Kybernetika-SPSE/DMP_Hep/PROJEKTOVA_DATA/Dilci_vypracovani/unor.docx

Dílčí vypracování únor:

Vyleptal jsem, osadil a zprovoznil plošný spoj pro vyhodnocování příchozích impulzů. Vše jsem zkompletoval a zprovoznil.

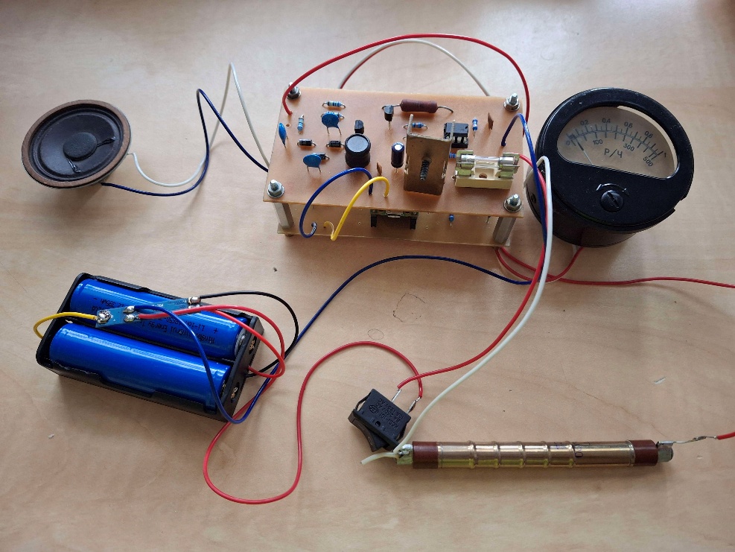
[picture p11: figure]
Obsah obrázku elektronika, Elektrické vedení, kabel, Elektronické inženýrství Obsah vygenerovaný umělou inteligencí může být nesprávný.

Dále jsem navrhl krabici, ke které bude celý produkt uložen.

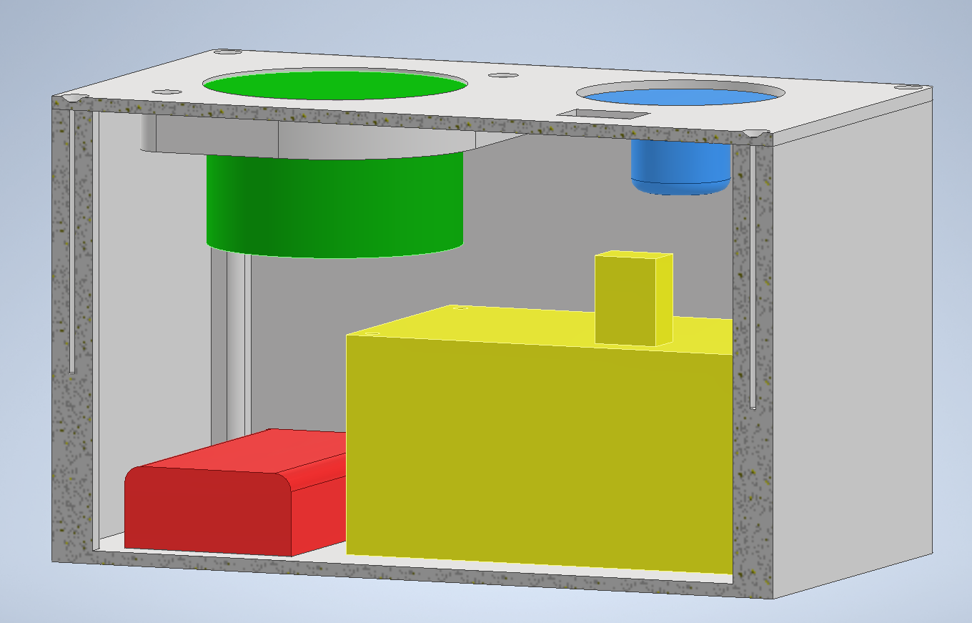
[picture p12: figure]
Obsah obrázku design Obsah vygenerovaný umělou inteligencí může být nesprávný.

Dále jsem se předběžně domluvil se známým, co je radiolog na kalibraci (zapůjčení zářiče se známou aktivitou).
