Kybernetika-SPSE/DMP_Hep/PROJEKTOVA_DATA/GeigerCounter/probe_2.stl

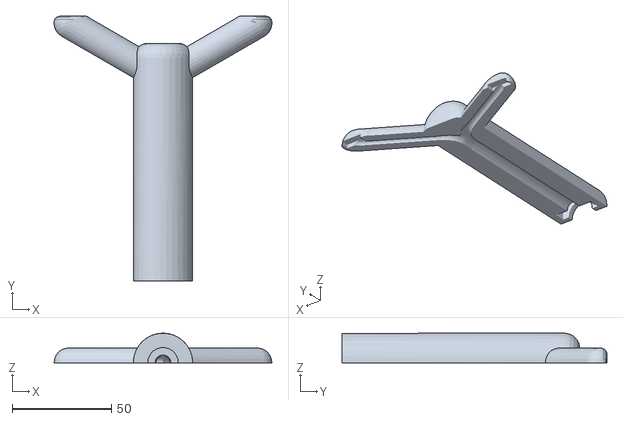
[picture p13: CAD file, 2025-04-10]
PROJEKTOVA_DATA/GeigerCounter/probe_2.stl
110.0 x 133.8 x 15.0
