Kybernetika-SPSE/DMP_Hep/PROJEKTOVA_DATA/GeigerCounter/cover.stl

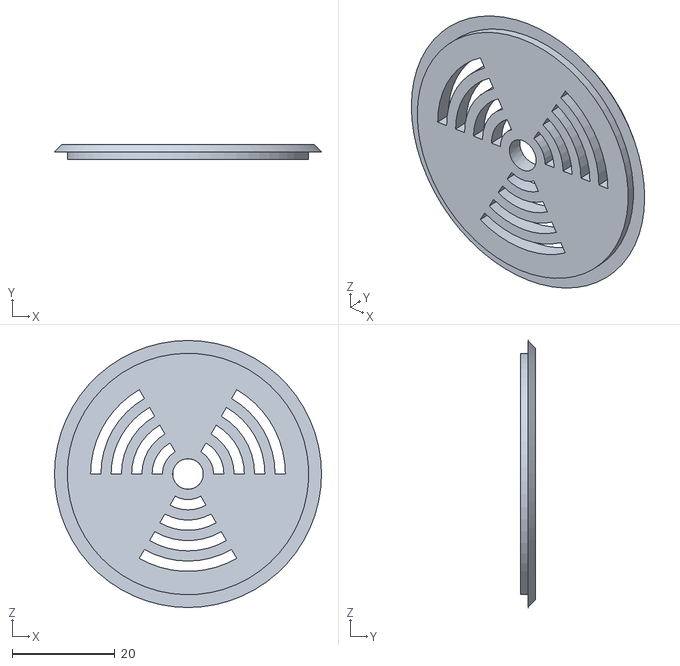
[picture p14: CAD file, 2025-04-10]
PROJEKTOVA_DATA/GeigerCounter/cover.stl
52.1 x 3.00 x 52.1
