Kybernetika-SPSE/DMP_Hep/PROJEKTOVA_DATA/GeigerCounter/probe_1.stl

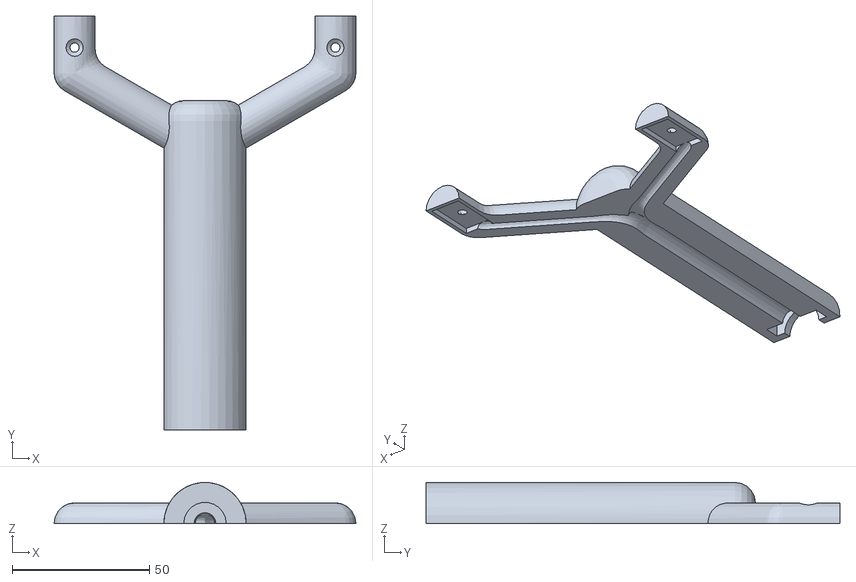
[picture p15: CAD file, 2025-04-10]
PROJEKTOVA_DATA/GeigerCounter/probe_1.stl
110.0 x 150.8 x 15.0
