Kybernetika-SPSE/DMP_Hep/PROJEKTOVA_DATA/GeigerCounter/box_bottom.stl

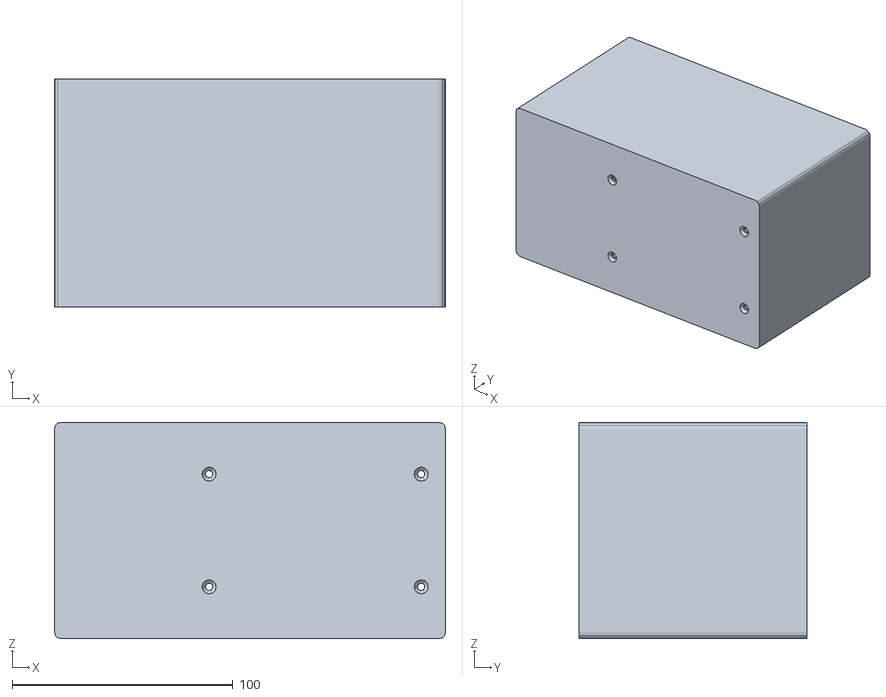
[picture p16: CAD file, 2025-03-24]
PROJEKTOVA_DATA/GeigerCounter/box_bottom.stl
177.0 x 103.0 x 98.0
