Kybernetika-SPSE/DMP_Hep/PROJEKTOVA_DATA/GeigerCounter/holder.stl

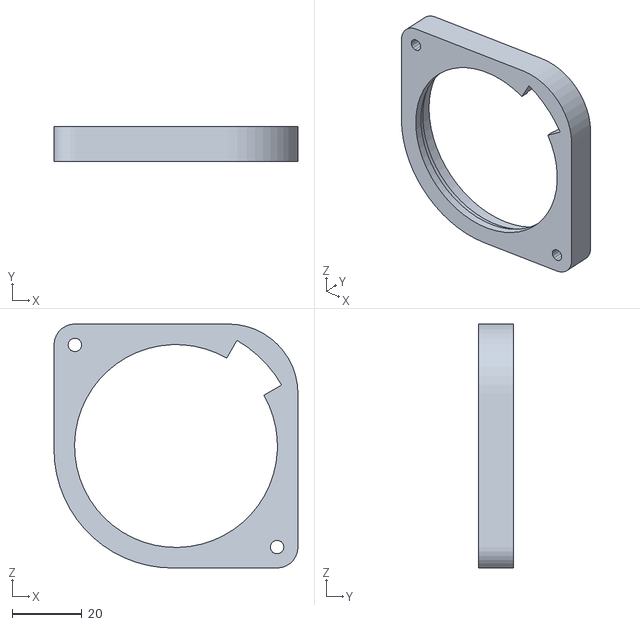
[picture p17: CAD file, 2025-03-24]
PROJEKTOVA_DATA/GeigerCounter/holder.stl
70.0 x 10.0 x 70.0
