Kybernetika-SPSE/DMP_Hep/PROJEKTOVA_DATA/GeigerCounter/box_top.stl

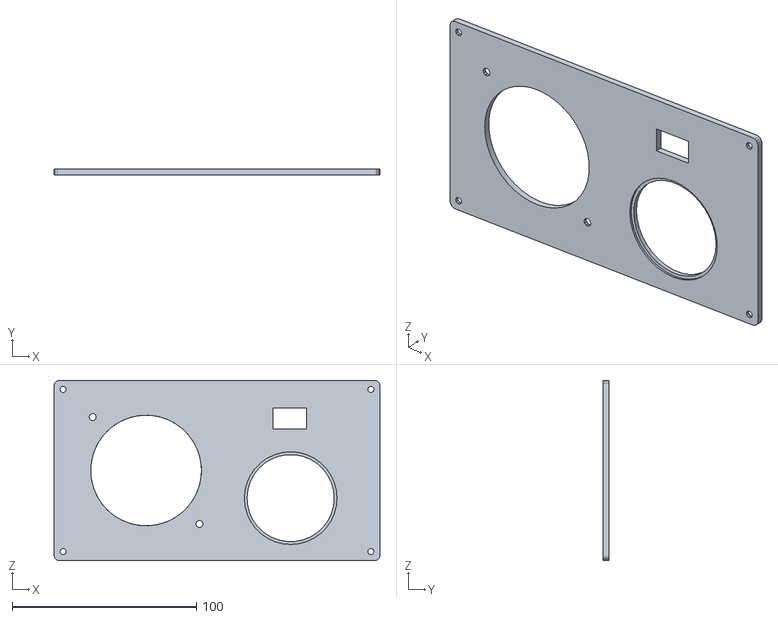
[picture p18: CAD file, 2025-03-24]
PROJEKTOVA_DATA/GeigerCounter/box_top.stl
177.0 x 3.00 x 98.0
