Kybernetika-SPSE/DMP_Hep/(list of files, cad)

Other CAD files:
PROJEKTOVA_DATA/GeigerCounter/MECHANISMUS TÁHLOVÝ.idw
PROJEKTOVA_DATA/GeigerCounter/OldVersions/Sestava1.0015.iam
PROJEKTOVA_DATA/GeigerCounter/OldVersions/Sestava2.0001.iam
PROJEKTOVA_DATA/GeigerCounter/OldVersions/box.0002.iam
PROJEKTOVA_DATA/GeigerCounter/OldVersions/box.0005.idw
PROJEKTOVA_DATA/GeigerCounter/OldVersions/box_bottom.0008.idw
PROJEKTOVA_DATA/GeigerCounter/OldVersions/box_bottom.0011.ipt
PROJEKTOVA_DATA/GeigerCounter/OldVersions/box_top.0007.idw
PROJEKTOVA_DATA/GeigerCounter/OldVersions/box_top.0011.ipt
PROJEKTOVA_DATA/GeigerCounter/OldVersions/cover.0005.idw
PROJEKTOVA_DATA/GeigerCounter/OldVersions/cover.0005.ipt
PROJEKTOVA_DATA/GeigerCounter/OldVersions/holder.0008.idw
PROJEKTOVA_DATA/GeigerCounter/OldVersions/holder.0012.ipt
PROJEKTOVA_DATA/GeigerCounter/OldVersions/probe.0002.iam
PROJEKTOVA_DATA/GeigerCounter/OldVersions/probe.0004.idw
PROJEKTOVA_DATA/GeigerCounter/OldVersions/probe_1.0004.idw
PROJEKTOVA_DATA/GeigerCounter/OldVersions/probe_1.0014.ipt
PROJEKTOVA_DATA/GeigerCounter/OldVersions/probe_2.0003.idw
PROJEKTOVA_DATA/GeigerCounter/OldVersions/probe_2.0004.ipt
PROJEKTOVA_DATA/GeigerCounter/OldVersions/prop.0001.ipt
PROJEKTOVA_DATA/GeigerCounter/OldVersions/prop_PCB.0002.ipt
PROJEKTOVA_DATA/GeigerCounter/OldVersions/prop_battery.0001.ipt
PROJEKTOVA_DATA/GeigerCounter/OldVersions/prop_meter.0001.ipt
PROJEKTOVA_DATA/GeigerCounter/OldVersions/prop_speaker.0001.ipt
PROJEKTOVA_DATA/GeigerCounter/OldVersions/stupnice.0010.idw
PROJEKTOVA_DATA/GeigerCounter/Sestava1.iam
PROJEKTOVA_DATA/GeigerCounter/Sestava2.iam
PROJEKTOVA_DATA/GeigerCounter/box.iam
PROJEKTOVA_DATA/GeigerCounter/box.idw
PROJEKTOVA_DATA/GeigerCounter/box_bottom.idw
PROJEKTOVA_DATA/GeigerCounter/box_bottom.ipt
PROJEKTOVA_DATA/GeigerCounter/box_top.idw
PROJEKTOVA_DATA/GeigerCounter/box_top.ipt
PROJEKTOVA_DATA/GeigerCounter/cover.idw
PROJEKTOVA_DATA/GeigerCounter/cover.ipt
PROJEKTOVA_DATA/GeigerCounter/holder.idw
PROJEKTOVA_DATA/GeigerCounter/holder.ipt
PROJEKTOVA_DATA/GeigerCounter/probe.iam
PROJEKTOVA_DATA/GeigerCounter/probe.idw
PROJEKTOVA_DATA/GeigerCounter/probe_1.idw
PROJEKTOVA_DATA/GeigerCounter/probe_1.ipt
PROJEKTOVA_DATA/GeigerCounter/probe_2.idw
PROJEKTOVA_DATA/GeigerCounter/probe_2.ipt
PROJEKTOVA_DATA/GeigerCounter/prop.ipt
PROJEKTOVA_DATA/GeigerCounter/prop_PCB.ipt
PROJEKTOVA_DATA/GeigerCounter/prop_battery.ipt
PROJEKTOVA_DATA/GeigerCounter/prop_meter.ipt
PROJEKTOVA_DATA/GeigerCounter/prop_speaker.ipt
PROJEKTOVA_DATA/GeigerCounter/stupnice.idw
