Kybernetika-SPSE/DMP_Hep/PRILOHY/PŘÍLOHA I - BOX_S_VÍKEM/box.pdf

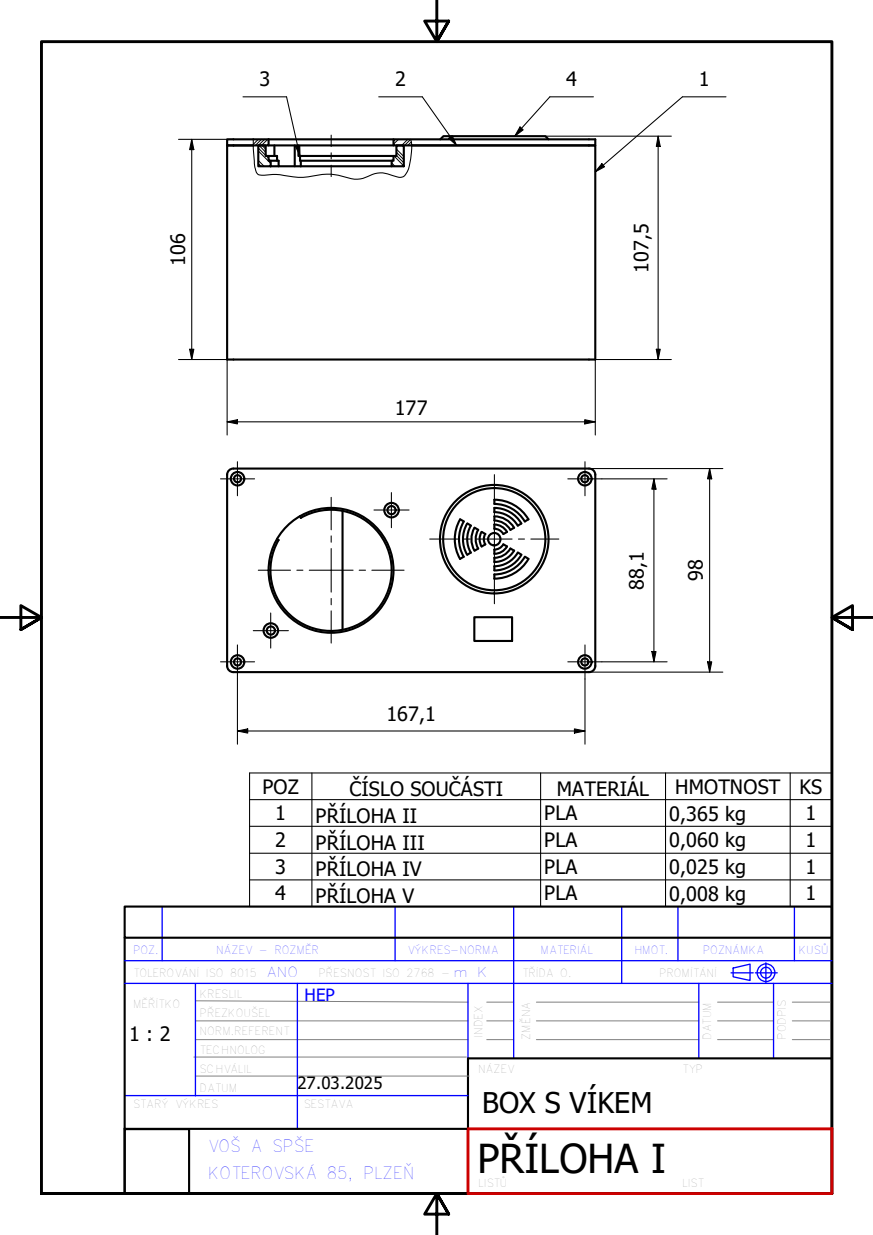
[picture p19: page 1]

POZ | ČÍSLO SOUČÁSTI | MATERIÁL | HMOTNOST | KS
1 | PŘÍLOHA II | PLA | 0,365 kg | 1
2 | PŘÍLOHA III | PLA | 0,060 kg | 1
3 | PŘÍLOHA IV | PLA | 0,025 kg | 1
4 | PŘÍLOHA V | PLA | 0,008 kg | 1

POZ. | NÁZEV - ROZMĚR | VÝKRES-NORMA | MATERIÁL | HMOT. | POZNÁMKA | KUSŮ

TOLEROVÁNÍ ISO 8015 ANO PŘESNOST ISO 2768 -m K | TŘÍDA O. | PROMÍTÁNÍ

MĚŘÍTKO 1 : 2 | KRESLIL | HEP

PŘEZKOUŠEL

NORM.REFERENT
TECHNOLOG
SCHVÁLIL | | NÁZEV TYP BOX S VÍKEM
DATUM | 27.03.2025

STARÝ VÝKRES | | SESTAVA

VOŠ A SPŠE KOTEROVSKÁ 85, PLZEŇ | PŘÍLOHA I LISTŮ LIST
