Kybernetika-SPSE/DMP_Hep/PRILOHY/PŘÍLOHA II - BOX/box_bottom.pdf

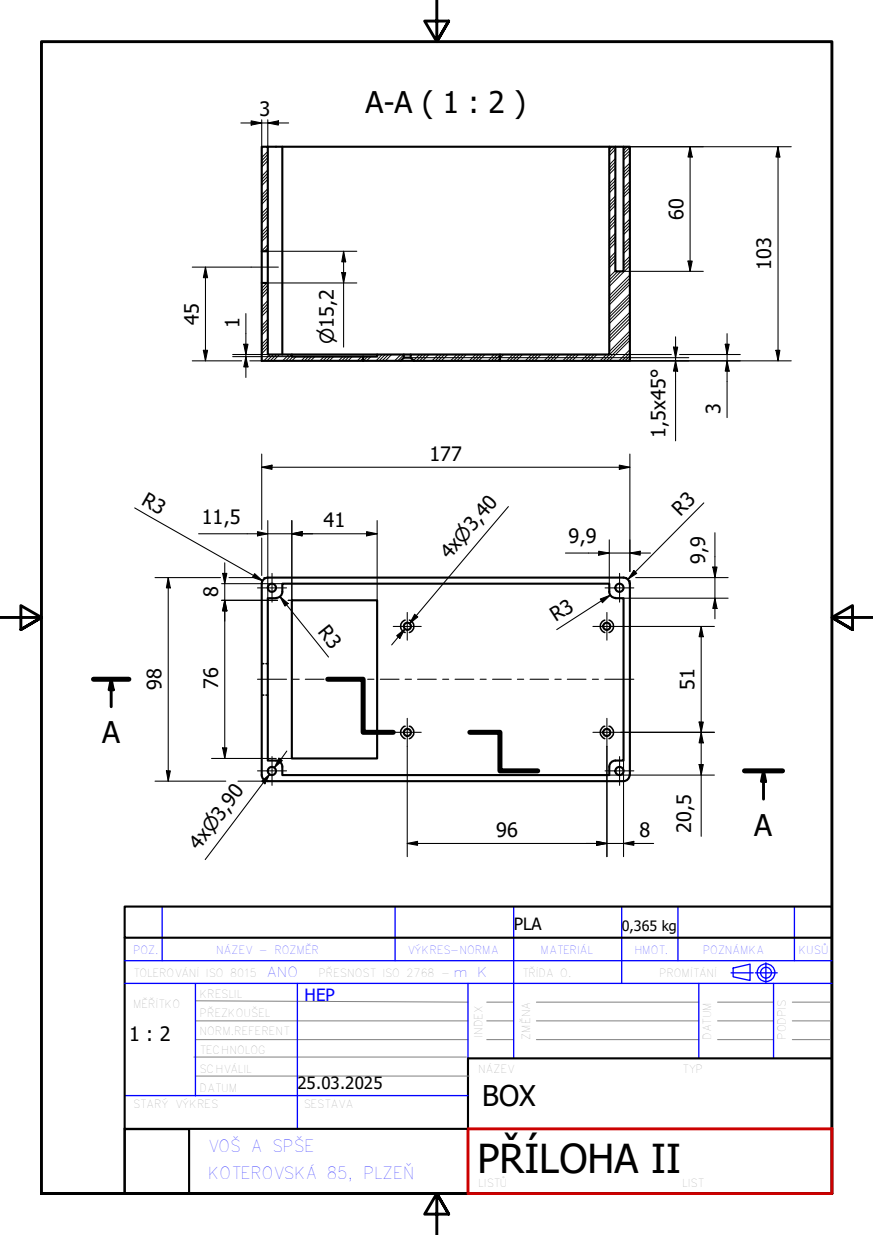
[picture p20: page 1]

PLA | 0,365 kg

POZ. | NÁZEV - ROZMĚR | VÝKRES-NORMA | MATERIÁL | HMOT. | POZNÁMKA | KUSŮ

TOLEROVÁNÍ ISO 8015 ANO PŘESNOST ISO 2768 -m K | TŘÍDA O. | PROMÍTÁNÍ

MĚŘÍTKO 1 : 2 | KRESLIL | HEP

PŘEZKOUŠEL

NORM.REFERENT
TECHNOLOG
SCHVÁLIL | | NÁZEV TYP BOX
DATUM | 25.03.2025

STARÝ VÝKRES | | SESTAVA

VOŠ A SPŠE KOTEROVSKÁ 85, PLZEŇ | PŘÍLOHA II LISTŮ LIST
