Kybernetika-SPSE/DMP_Hep/PRILOHY/PŘÍLOHA III - VÍKO/box_top.pdf

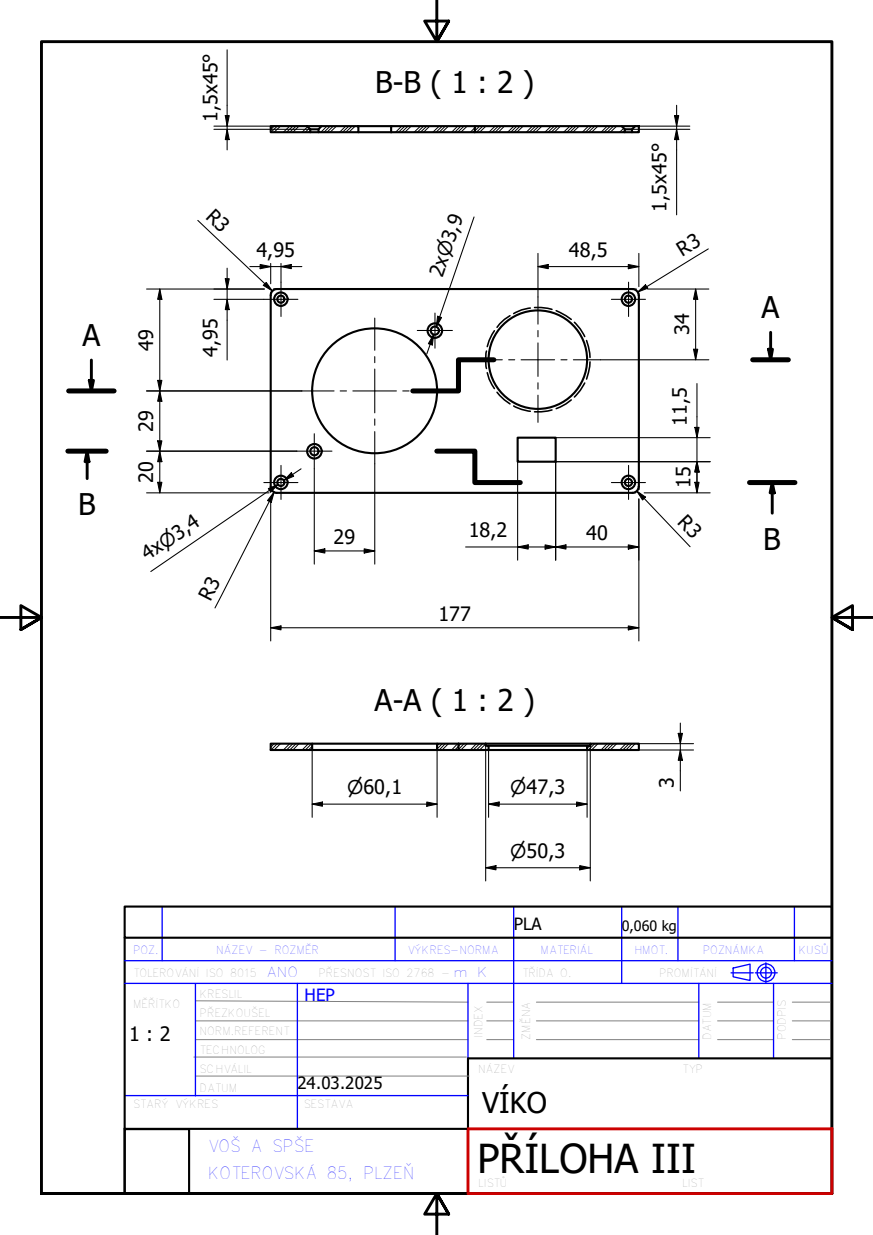
[picture p21: page 1]

PLA | 0,060 kg

POZ. | NÁZEV - ROZMĚR | VÝKRES-NORMA | MATERIÁL | HMOT. | POZNÁMKA | KUSŮ

TOLEROVÁNÍ ISO 8015 ANO PŘESNOST ISO 2768 -m K | TŘÍDA O. | PROMÍTÁNÍ

MĚŘÍTKO 1 : 2 | KRESLIL | HEP

PŘEZKOUŠEL

NORM.REFERENT
TECHNOLOG
SCHVÁLIL | | NÁZEV TYP VÍKO
DATUM | 24.03.2025

STARÝ VÝKRES | | SESTAVA

VOŠ A SPŠE KOTEROVSKÁ 85, PLZEŇ | PŘÍLOHA III LISTŮ LIST
