Kybernetika-SPSE/DMP_Hep/PRILOHY/PŘÍLOHA IV - OBJÍMKA/holder.pdf

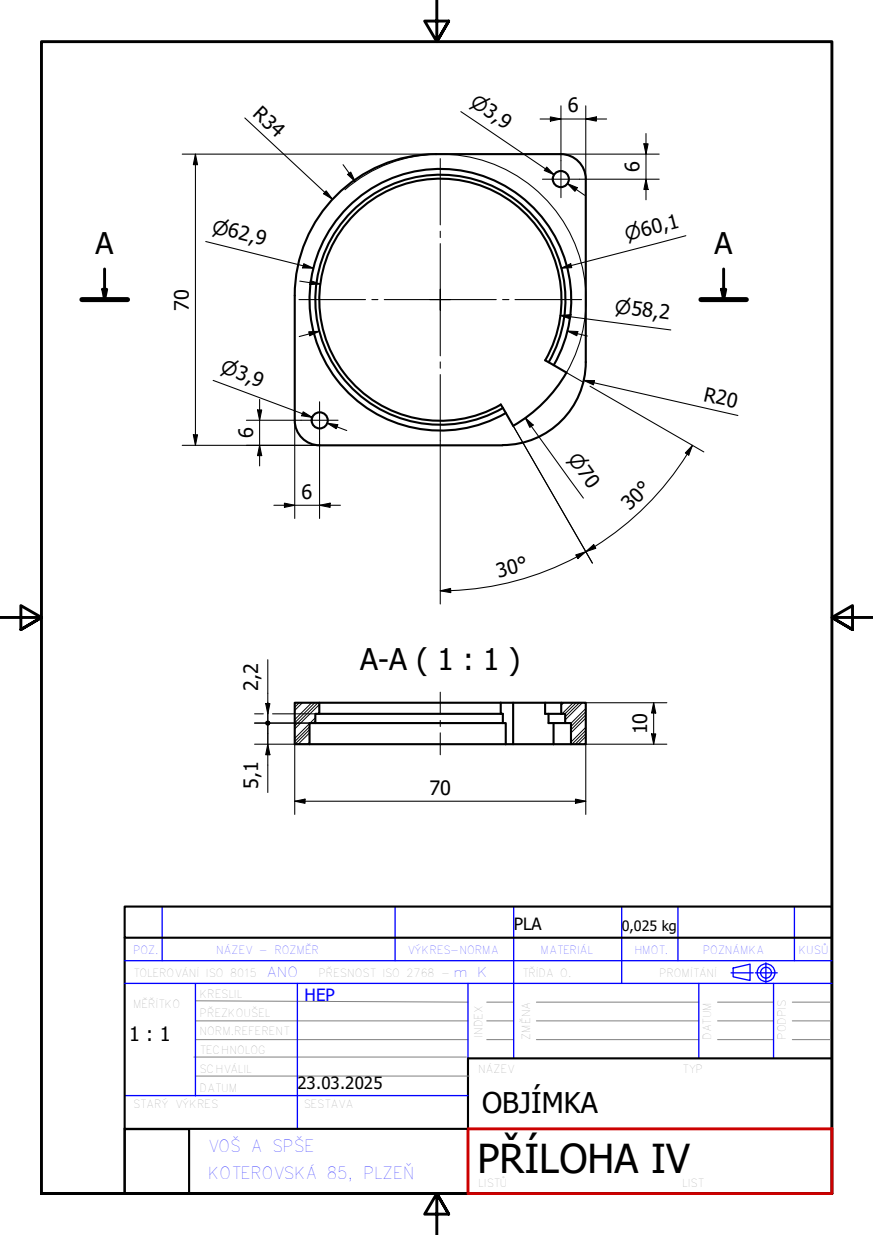
[picture p22: page 1]

PLA | 0,025 kg

POZ. | NÁZEV - ROZMĚR | VÝKRES-NORMA | MATERIÁL | HMOT. | POZNÁMKA | KUSŮ

TOLEROVÁNÍ ISO 8015 ANO PŘESNOST ISO 2768 -m K | TŘÍDA O. | PROMÍTÁNÍ

MĚŘÍTKO 1 : 1 | KRESLIL | HEP

PŘEZKOUŠEL

NORM.REFERENT
TECHNOLOG
SCHVÁLIL | | NÁZEV TYP OBJÍMKA
DATUM | 23.03.2025

STARÝ VÝKRES | | SESTAVA

VOŠ A SPŠE KOTEROVSKÁ 85, PLZEŇ | PŘÍLOHA IV LISTŮ LIST
