Kybernetika-SPSE/DMP_Hep/PRILOHY/PŘÍLOHA V - KRYT/cover.pdf

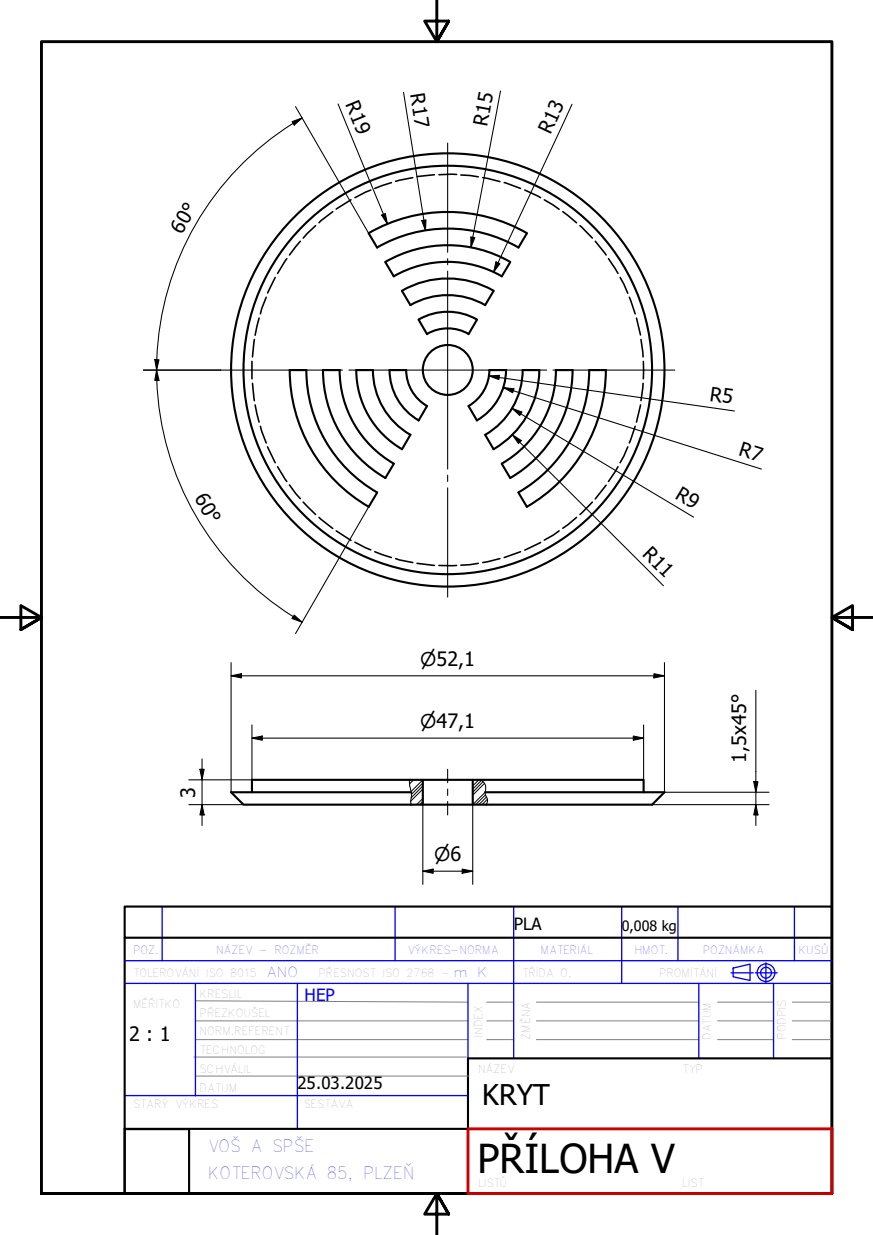
[picture p23: page 1]

PLA | 0,008 kg

POZ. | NÁZEV - ROZMĚR | VÝKRES-NORMA | MATERIÁL | HMOT. | POZNÁMKA | KUSŮ

TOLEROVÁNÍ ISO 8015 ANO PŘESNOST ISO 2768 -m K | TŘÍDA O. | PROMÍTÁNÍ

MĚŘÍTKO 2 : 1 | KRESLIL | HEP

PŘEZKOUŠEL

NORM.REFERENT
TECHNOLOG
SCHVÁLIL | | NÁZEV TYP KRYT
DATUM | 25.03.2025

STARÝ VÝKRES | | SESTAVA

VOŠ A SPŠE KOTEROVSKÁ 85, PLZEŇ | PŘÍLOHA V LISTŮ LIST
