Kybernetika-SPSE/DMP_Hep/PRILOHY/PŘÍLOHA VI - SONDA/probe.pdf

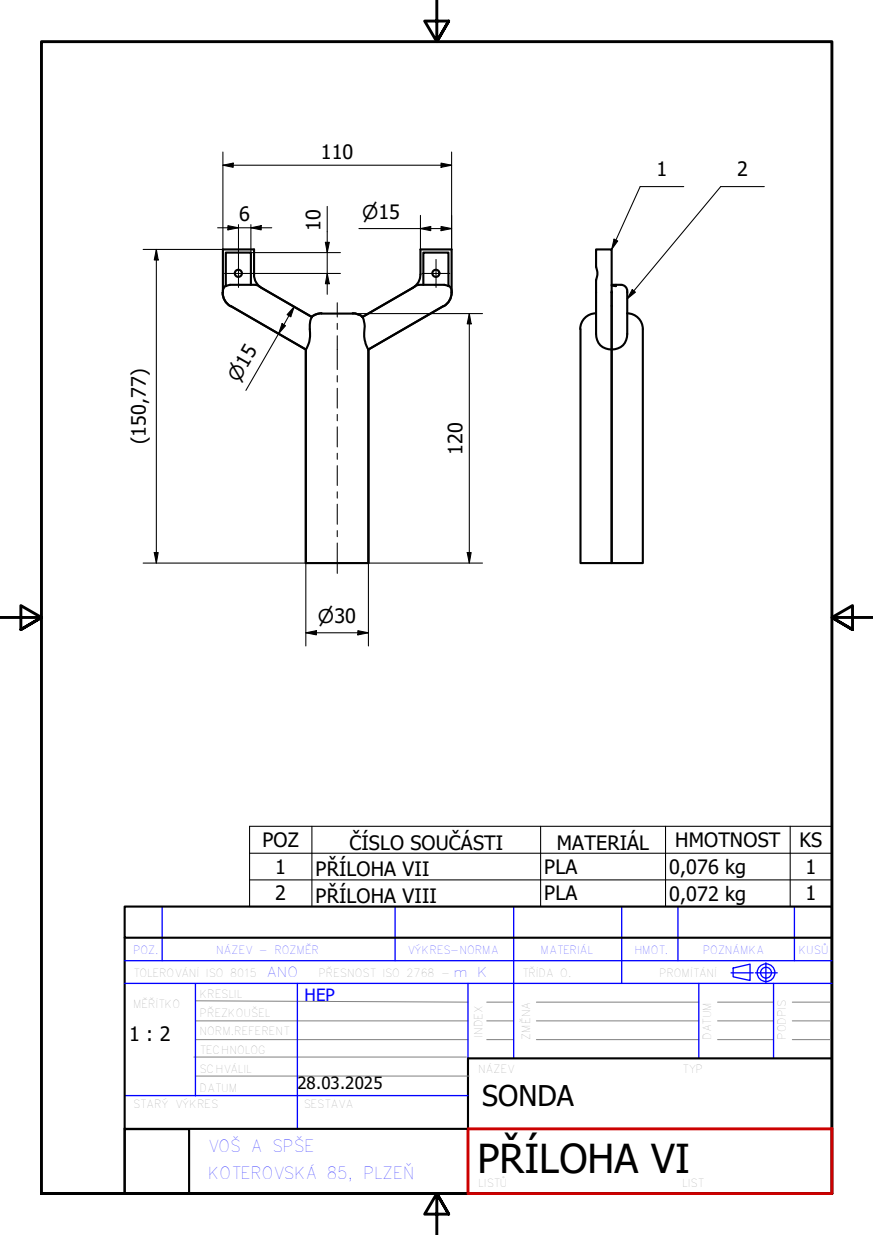
[picture p24: page 1]

POZ | ČÍSLO SOUČÁSTI | MATERIÁL | HMOTNOST | KS
1 | PŘÍLOHA VII | PLA | 0,076 kg | 1
2 | PŘÍLOHA VIII | PLA | 0,072 kg | 1

POZ. | NÁZEV - ROZMĚR | VÝKRES-NORMA | MATERIÁL | HMOT. | POZNÁMKA | KUSŮ

TOLEROVÁNÍ ISO 8015 ANO PŘESNOST ISO 2768 -m K | TŘÍDA O. | PROMÍTÁNÍ

MĚŘÍTKO 1 : 2 | KRESLIL | HEP

PŘEZKOUŠEL

NORM.REFERENT
TECHNOLOG
SCHVÁLIL | | NÁZEV TYP SONDA
DATUM | 28.03.2025

STARÝ VÝKRES | | SESTAVA

VOŠ A SPŠE KOTEROVSKÁ 85, PLZEŇ | PŘÍLOHA VI LISTŮ LIST
