Kybernetika-SPSE/DMP_Hep/PROJEKTOVA_DATA/GeigerCounter/stupnice.pdf

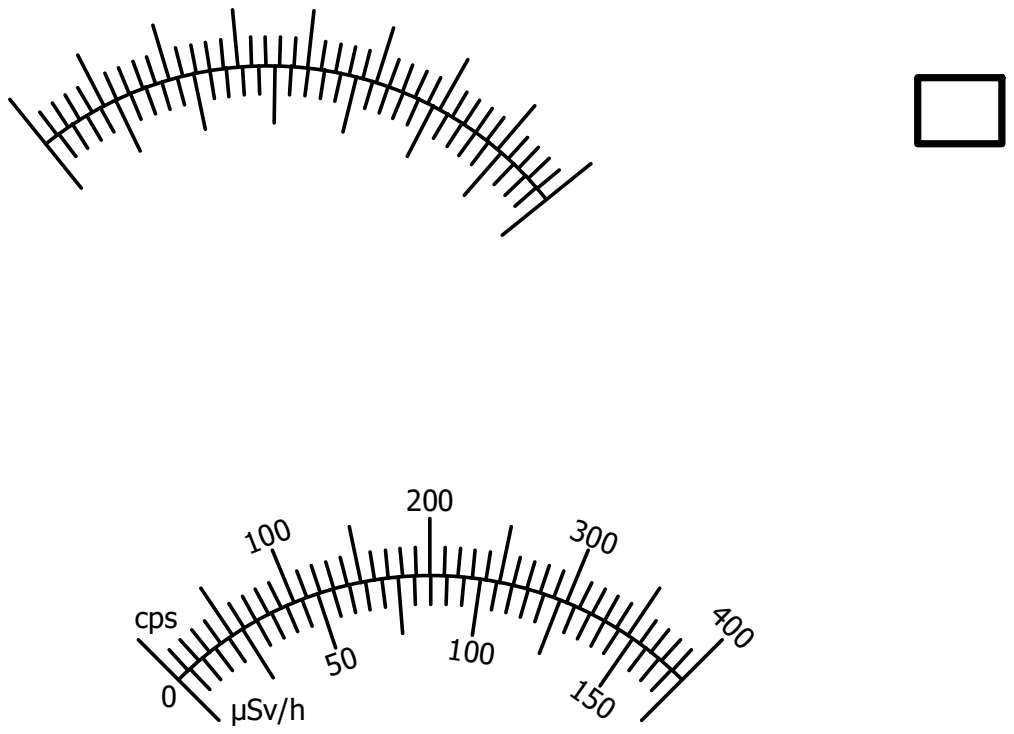
[picture p26: page 1]
Kreslil; Kontroloval; Schválil - dne; Datum
