Kybernetika-SPSE/DMP_Hep/(commit log)

2025-01-06 pcb update
    [Geiger-Muller.kicad_pcb, Geiger-Muller.kicad_sch]
2025-02-02 code update and PCB
    [geiger_muller_detector.kicad_pcb, geiger_muller_detector.kicad_sch]
2025-03-24 hej bejku
    [MECHANISMUS TÁHLOVÝ.idw, Sestava1.0012.iam, Sestava1.iam, box_bottom.0009.ipt, box_bottom.ipt, box_bottom.stl, box_top.0009.ipt, box_top.ipt]
2025-04-10 git lab push
    [MECHANISMUS TÁHLOVÝ.idw, Sestava1.0015.iam, Sestava1.iam, Sestava2.0001.iam, Sestava2.iam, box.0002.iam, box.0005.idw, box.iam]
2025-04-10 Delete samples.xlsx
    delete
    [samples.xlsx]
2025-04-10 Delete geiger_muller_detector directory
    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
    [geiger_muller_detector.kicad_pcb, geiger_muller_detector.kicad_sch]
2025-04-10 Delete geiger_muller_hv directory
    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
    [geiger_muller_hv.kicad_pcb, geiger_muller_hv.kicad_sch]
2025-04-10 Delete GeigerCounter directory
    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
    [MECHANISMUS TÁHLOVÝ.idw, Sestava1.0012.iam, Sestava1.iam, box_bottom.0009.ipt, box_bottom.ipt, box_bottom.stl, box_top.0009.ipt, box_top.ipt]
2025-04-10 Delete projektova_data directory
    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
    [MECHANISMUS TÁHLOVÝ.idw, Sestava1.0015.iam, Sestava1.iam, Sestava2.0001.iam, Sestava2.iam, box.0002.iam, box.0005.idw, box.iam]
2025-04-10 zkurveny git
    [MECHANISMUS TÁHLOVÝ.idw, Sestava1.0015.iam, Sestava1.iam, Sestava2.0001.iam, Sestava2.iam, box.0002.iam, box.0005.idw, box.iam]
